mangia3/bird/README.md

# bird

revisiting one of my high school senior thesis projects

[[timf](https://aryan-cs.github.io/bird/timf.pdf)] [[rcgroup](https://www.rcgroups.com/forums/showthread.php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)]
