mangia3/bird/jet/LW-PLA/F22_Raptor_Fuselage/Sawtooth_Nosecone/f22_raptor_nose_main.stl

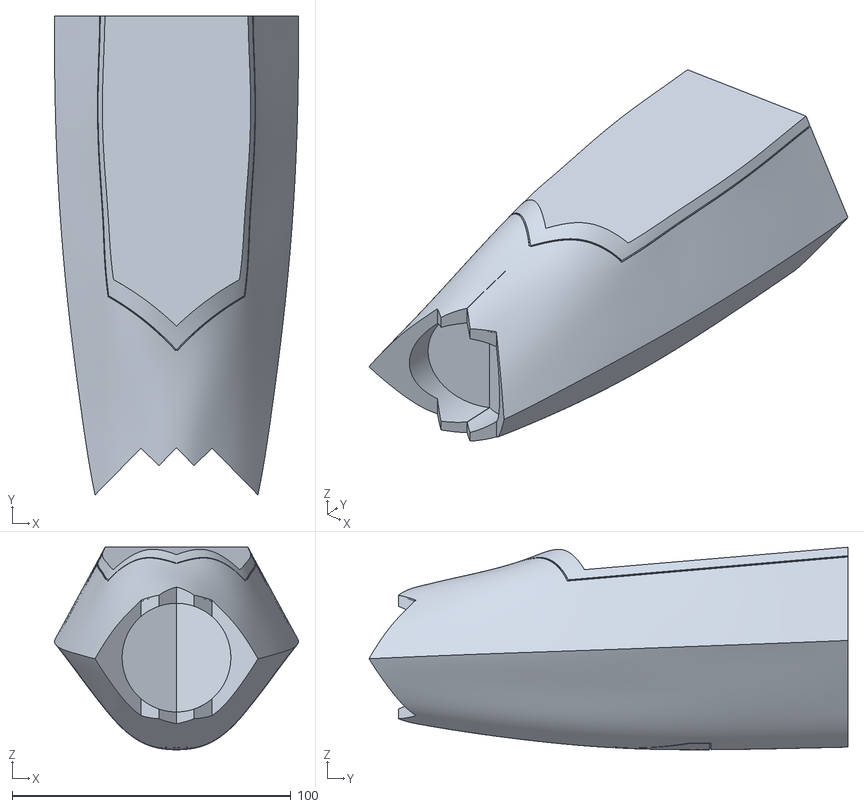
[picture p9: CAD file, 2026-05-17]
jet/LW-PLA/F22_Raptor_Fuselage/Sawtooth_Nosecone/f22_raptor_nose_main.stl
87.7 x 171.9 x 72.7
