mangia3/bird/jet/LW-PLA/F22_Raptor_Fuselage/f22_raptor_fuse_3_twin.stl

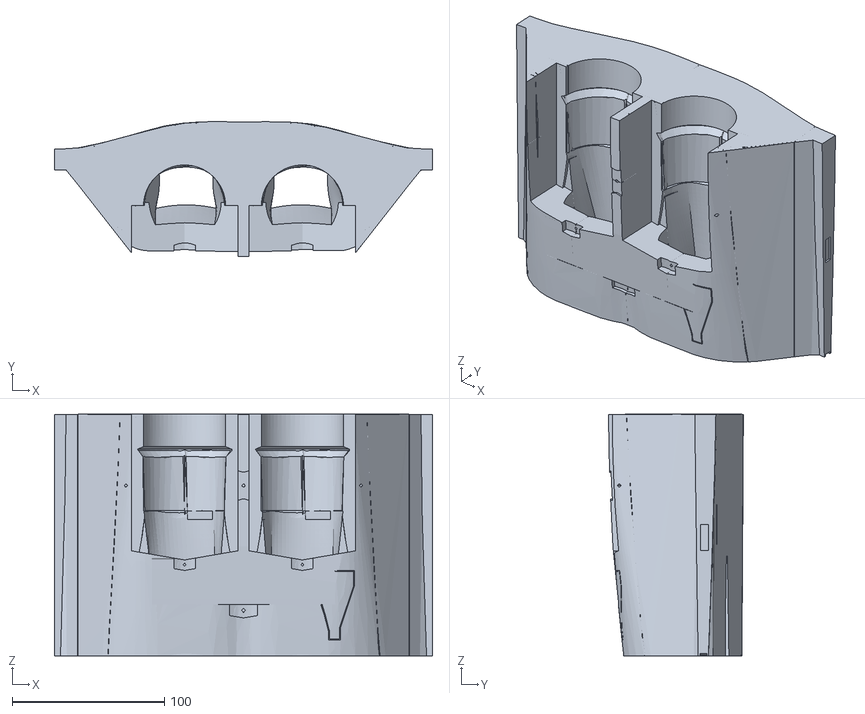
[picture p10: CAD file, 2026-06-01]
jet/LW-PLA/F22_Raptor_Fuselage/f22_raptor_fuse_3_twin.stl
248.3 x 88.5 x 158.6
