mangia3/bird/jet/LW-PLA/F22_Raptor_Fuselage/Simple_Nosecone/f22_raptor_nose_2.stl

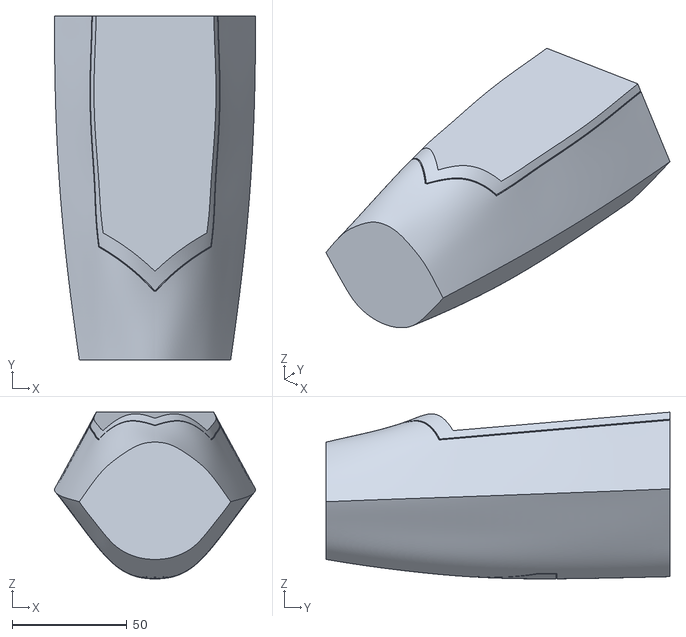
[picture p11: CAD file, 2026-05-17]
jet/LW-PLA/F22_Raptor_Fuselage/Simple_Nosecone/f22_raptor_nose_2.stl
87.7 x 150.0 x 72.7
