mangia3/bird/jet/LW-PLA/F22_Raptor_HStab/f22_raptor_hstab_l.stl

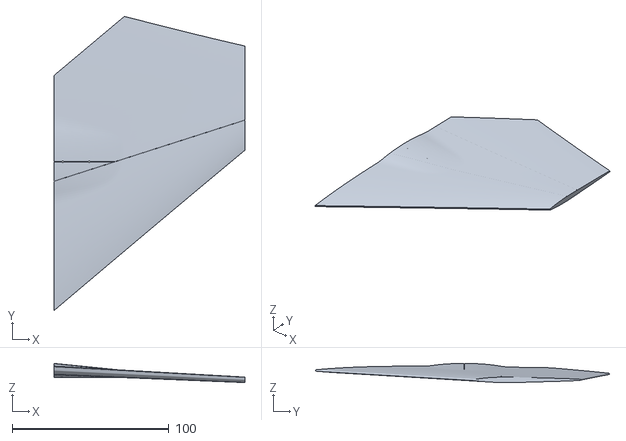
[picture p12: CAD file, 2026-05-17]
jet/LW-PLA/F22_Raptor_HStab/f22_raptor_hstab_l.stl
122.0 x 187.9 x 12.3
