mangia3/bird/jet/LW-PLA/F22_Raptor_VStab/f22_raptor_rear_vstab_r.stl

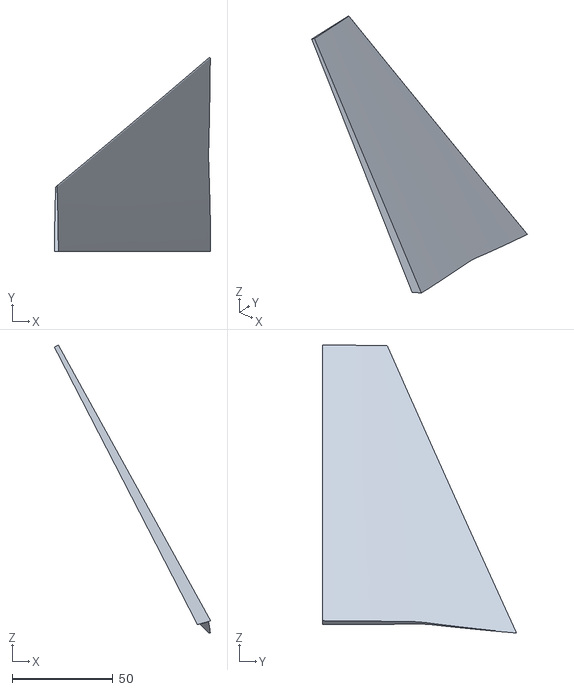
[picture p13: CAD file, 2026-05-17]
jet/LW-PLA/F22_Raptor_VStab/f22_raptor_rear_vstab_r.stl
77.5 x 96.3 x 142.9
