mangia3/bird/jet/LW-PLA/F22_Raptor_Wings/F22_Raptor_Wing_Left/f22_raptor_wing_l_tip.stl

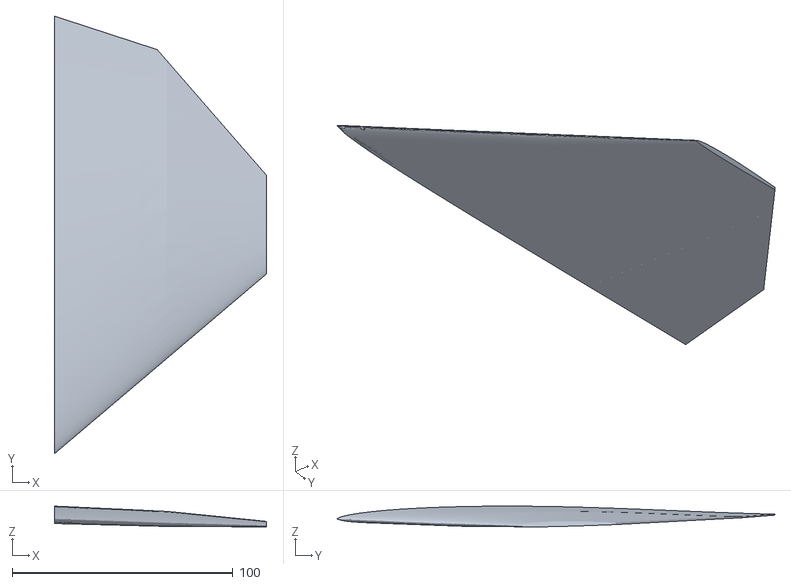
[picture p14: CAD file, 2026-05-17]
jet/LW-PLA/F22_Raptor_Wings/F22_Raptor_Wing_Left/f22_raptor_wing_l_tip.stl
96.0 x 198.2 x 9.42
