mangia3/bird/jet/LW-PLA/F22_Raptor_Wings/F22_Raptor_Wing_Right/f22_wing_r1b_no_servo.stl

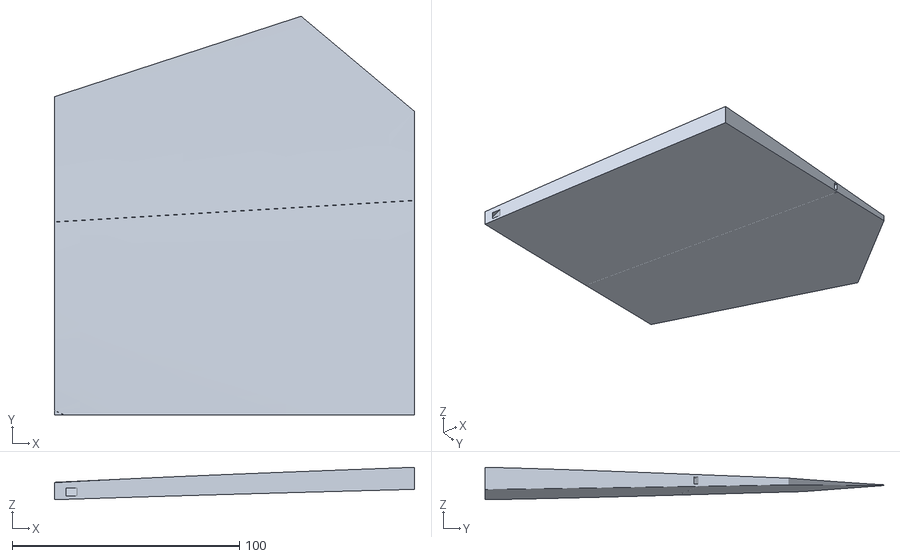
[picture p15: CAD file, 2026-05-17]
jet/LW-PLA/F22_Raptor_Wings/F22_Raptor_Wing_Right/f22_wing_r1b_no_servo.stl
158.5 x 175.5 x 14.3
