mangia3/bird/jet/LW-PLA/F22_Raptor_Fuselage/f22_raptor_fuse_4_twin.stl

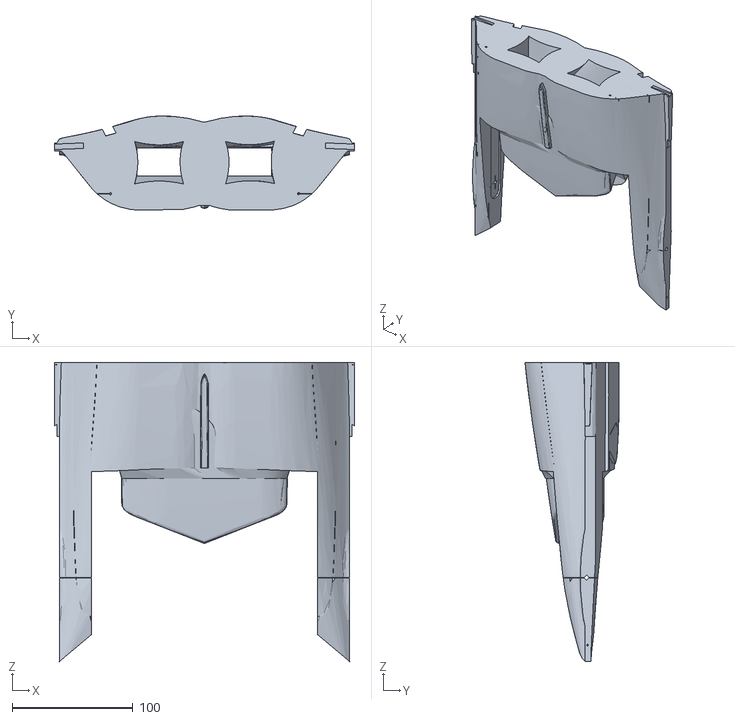
[picture p16: CAD file, 2026-06-01]
jet/LW-PLA/F22_Raptor_Fuselage/f22_raptor_fuse_4_twin.stl
248.3 x 77.9 x 247.5
