mangia3/bird/jet/LW-PLA/F22_Raptor_HStab/f22_raptor_hstab_l_rear.stl

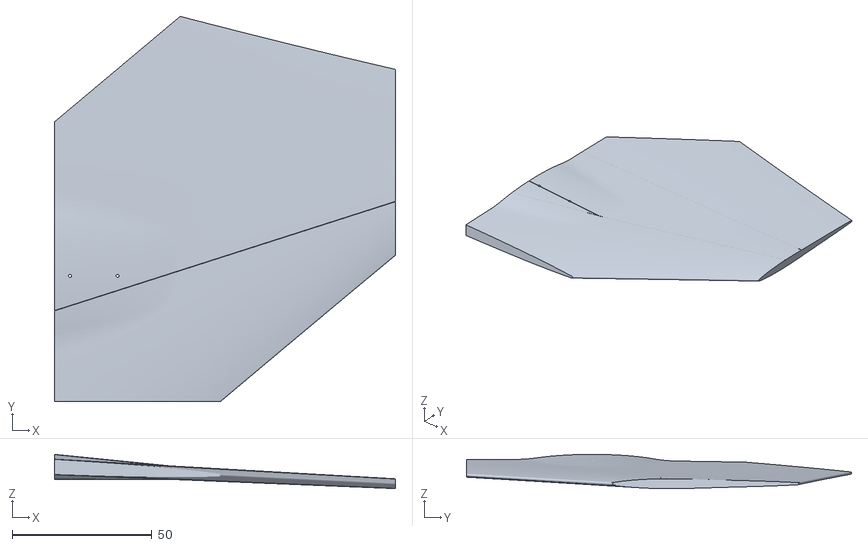
[picture p17: CAD file, 2026-05-17]
jet/LW-PLA/F22_Raptor_HStab/f22_raptor_hstab_l_rear.stl
122.0 x 137.8 x 12.3
