mangia3/bird/jet/LW-PLA/F22_Raptor_VStab/f22_raptor_vstab_l.stl

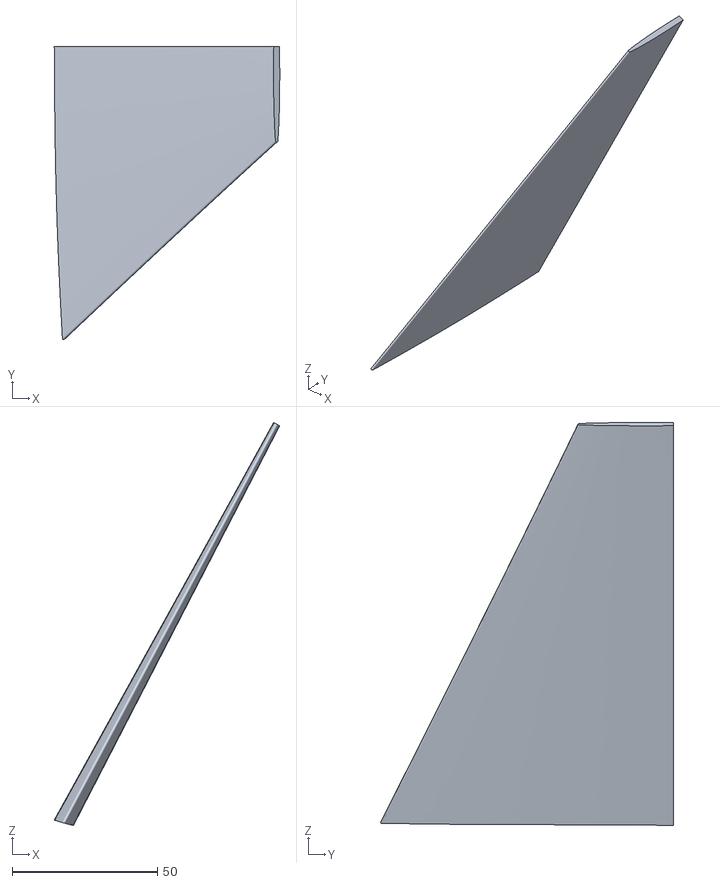
[picture p18: CAD file, 2026-05-17]
jet/LW-PLA/F22_Raptor_VStab/f22_raptor_vstab_l.stl
77.6 x 101.0 x 138.7
