mangia3/bird/jet/LW-PLA/F22_Raptor_Wings/F22_Raptor_Wing_Right/f22_raptor_wing_r1b.stl

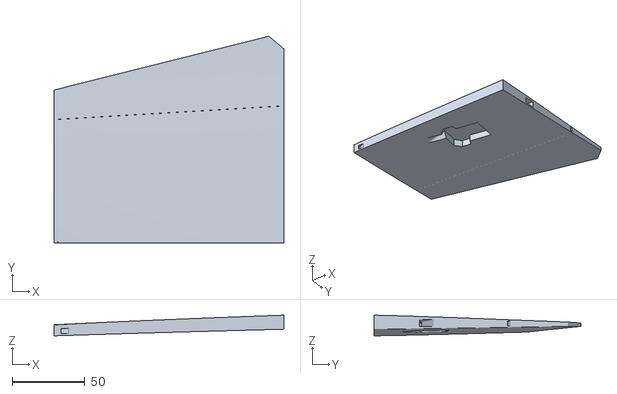
[picture p19: CAD file, 2026-05-17]
jet/LW-PLA/F22_Raptor_Wings/F22_Raptor_Wing_Right/f22_raptor_wing_r1b.stl
158.5 x 142.3 x 14.3
