mangia3/bird/jet/LW-PLA/F22_Raptor_Fuselage/f22_raptor_fuse_2_twin.stl

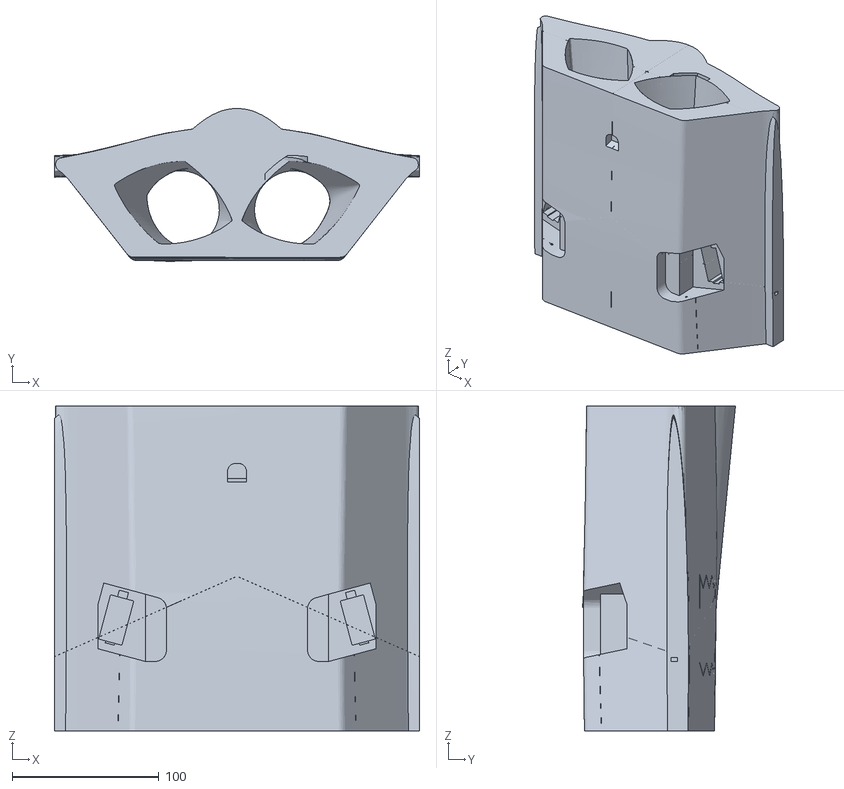
[picture p20: CAD file, 2026-06-01]
jet/LW-PLA/F22_Raptor_Fuselage/f22_raptor_fuse_2_twin.stl
248.3 x 104.1 x 221.0
