mangia3/bird/jet/LW-PLA/F22_Raptor_HStab/f22_raptor_taileron_horn.stl

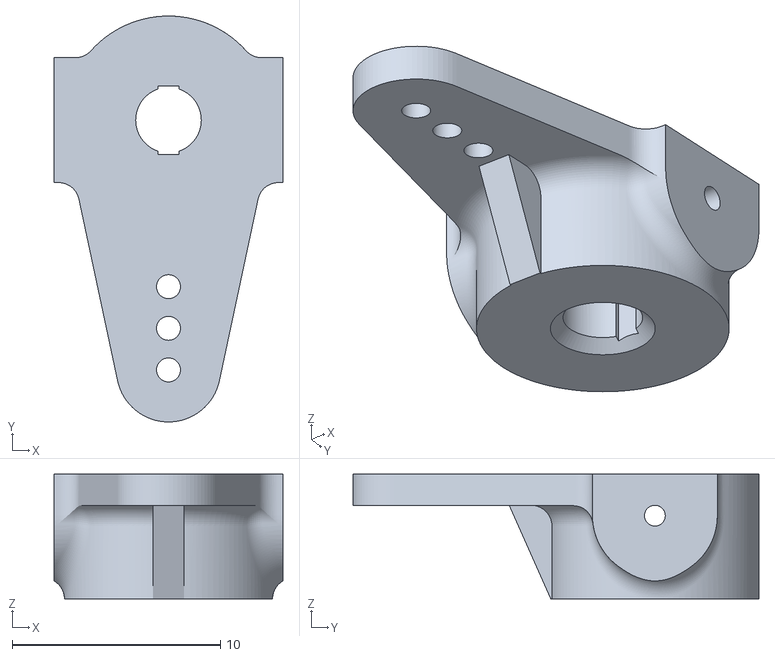
[picture p21: CAD file, 2026-05-17]
jet/LW-PLA/F22_Raptor_HStab/f22_raptor_taileron_horn.stl
11.0 x 19.5 x 6.00
