mangia3/bird/jet/LW-PLA/F22_Raptor_Wings/F22_Raptor_Wing_Right/f22_raptor_r_ail_outer.stl

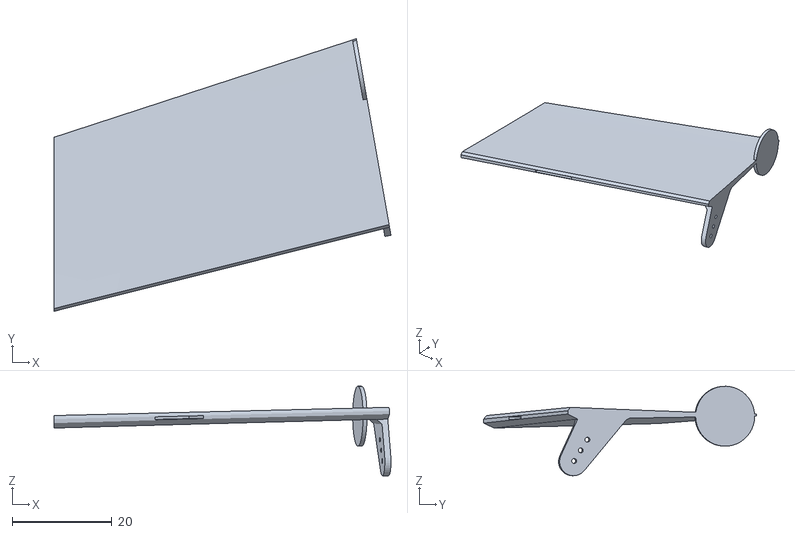
[picture p22: CAD file, 2026-05-17]
jet/LW-PLA/F22_Raptor_Wings/F22_Raptor_Wing_Right/f22_raptor_r_ail_outer.stl
67.4 x 54.5 x 17.9
