mangia3/bird/jet/LW-PLA/F22_Raptor_Fuselage/f22_raptor_fuse_3.stl

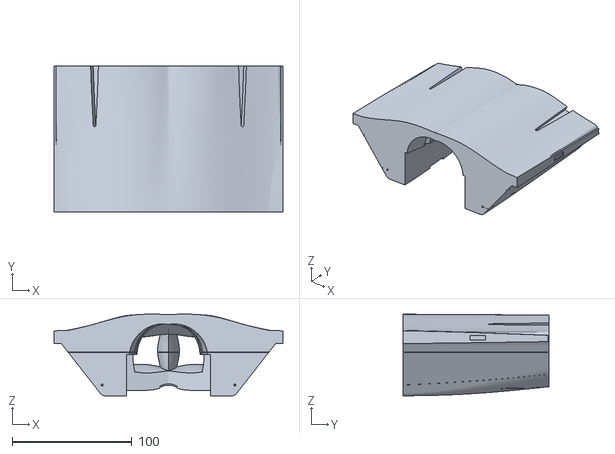
[picture p23: CAD file, 2026-05-17]
jet/LW-PLA/F22_Raptor_Fuselage/f22_raptor_fuse_3.stl
191.0 x 122.0 x 68.2
