mangia3/bird/jet/LW-PLA/F22_Raptor_Wings/F22_Raptor_Wing_Left/f22_raptor_l_ail_inner.stl

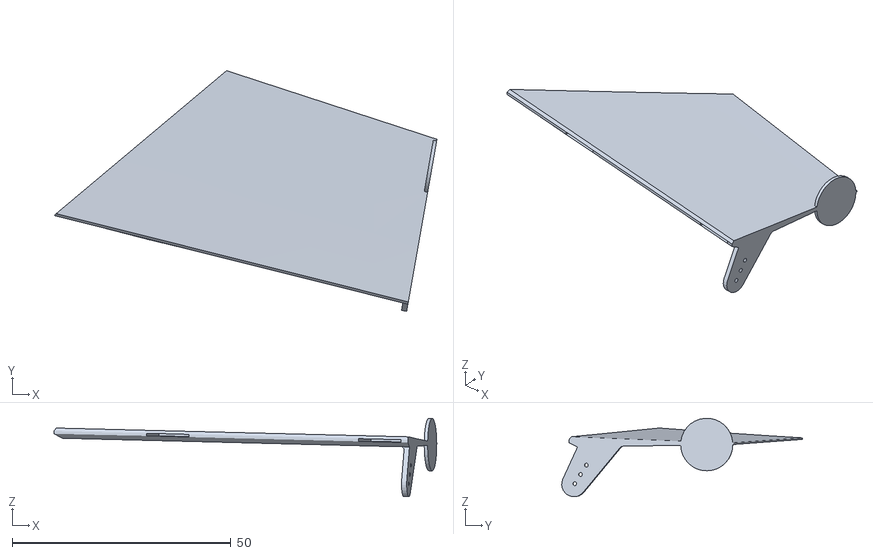
[picture p24: CAD file, 2026-05-17]
jet/LW-PLA/F22_Raptor_Wings/F22_Raptor_Wing_Left/f22_raptor_l_ail_inner.stl
87.6 x 55.0 x 17.9
