mangia3/bird/jet/LW-PLA/F22_Raptor_Fuselage/f22_raptor_fuse_1_lowfloor.stl

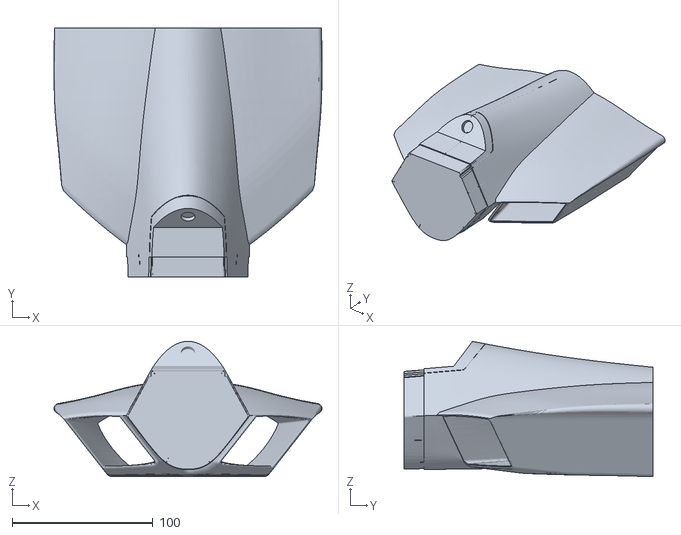
[picture p25: CAD file, 2026-05-17]
jet/LW-PLA/F22_Raptor_Fuselage/f22_raptor_fuse_1_lowfloor.stl
190.6 x 177.0 x 96.3
