mangia3/bird/jet/LW-PLA/F22_Raptor_Fuselage/f22_raptor_fan_hatch.stl

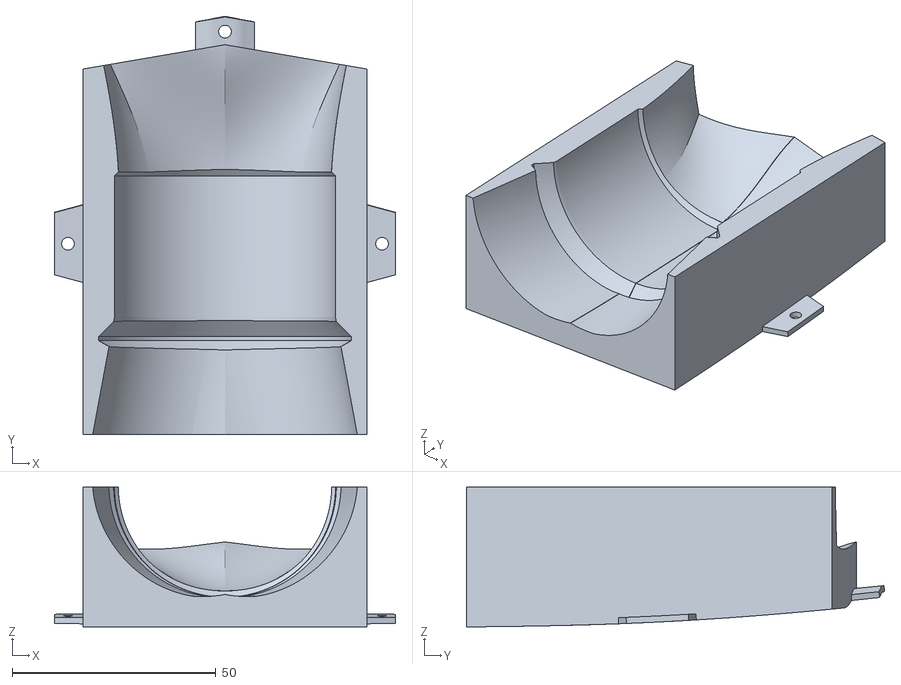
[picture p26: CAD file, 2026-05-17]
jet/LW-PLA/F22_Raptor_Fuselage/f22_raptor_fan_hatch.stl
83.6 x 102.5 x 34.3
