mangia3/bird/jet/LW-PLA/F22_Raptor_HStab/f22_raptor_hstab_l_front.stl

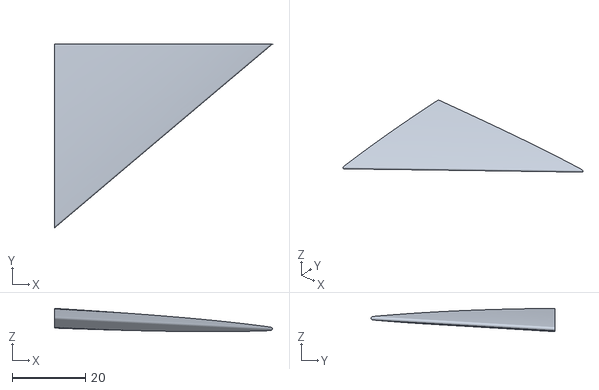
[picture p27: CAD file, 2026-05-17]
jet/LW-PLA/F22_Raptor_HStab/f22_raptor_hstab_l_front.stl
59.4 x 50.1 x 6.35
