mangia3/bird/jet/LW-PLA/F22_Raptor_Fuselage/f22_raptor_fuse_4_laminate_r.stl

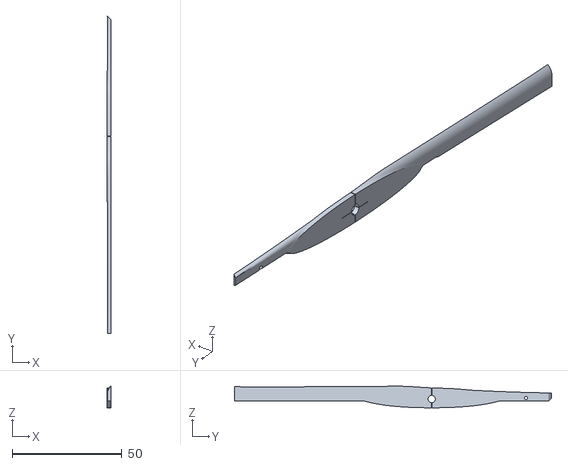
[picture p28: CAD file, 2026-05-17]
jet/LW-PLA/F22_Raptor_Fuselage/f22_raptor_fuse_4_laminate_r.stl
1.60 x 144.7 x 9.87
