mangia3/bird/jet/LW-PLA/F22_Raptor_Fuselage/f22_raptor_canopy.stl

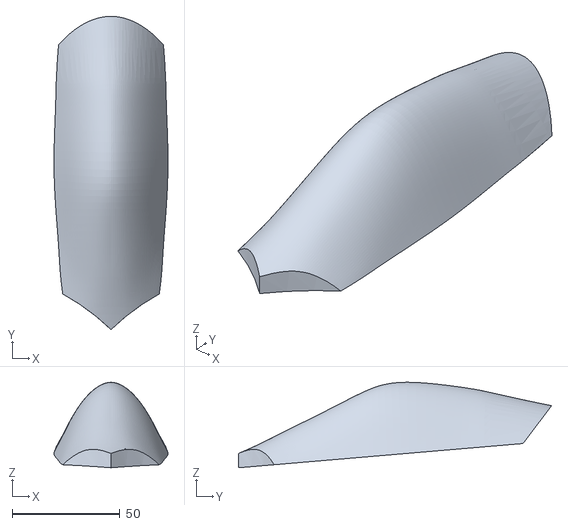
[picture p30: CAD file, 2026-05-17]
jet/LW-PLA/F22_Raptor_Fuselage/f22_raptor_canopy.stl
53.0 x 145.6 x 39.8
