mangia3/bird/jet/LW-PLA/F22_Raptor_Fuselage/f22_raptor_ele_horn_cover_r.stl

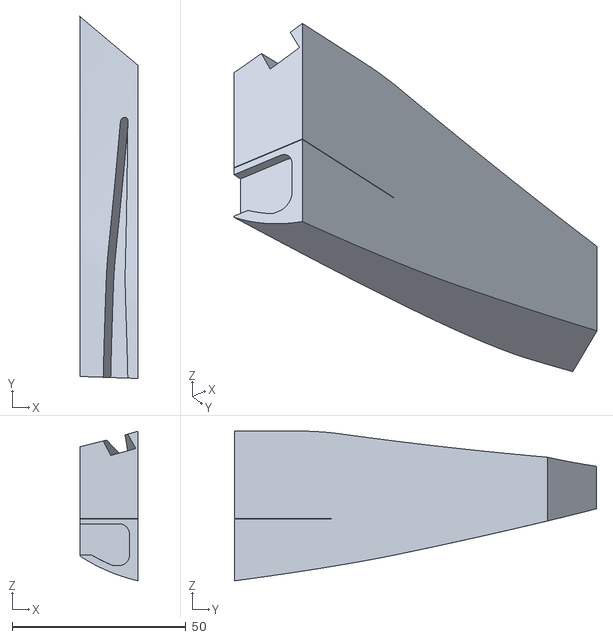
[picture p31: CAD file, 2026-05-17]
jet/LW-PLA/F22_Raptor_Fuselage/f22_raptor_ele_horn_cover_r.stl
16.8 x 104.1 x 43.1
