mangia3/bird/jet/LW-PLA/F22_Raptor_Fuselage/f22_raptor_fuse_4_laminate_l2.stl

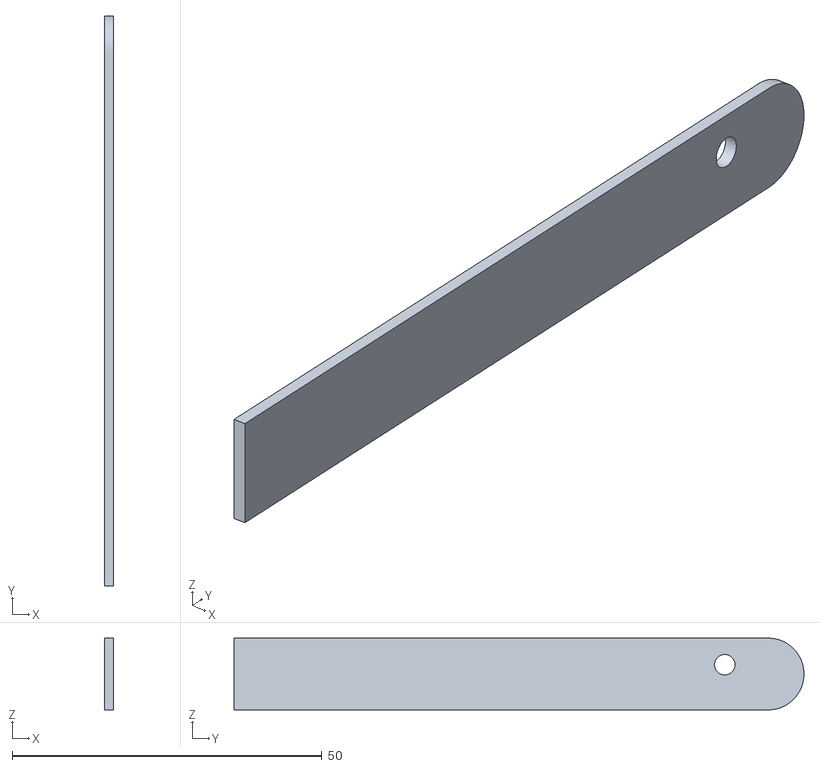
[picture p32: CAD file, 2026-05-17]
jet/LW-PLA/F22_Raptor_Fuselage/f22_raptor_fuse_4_laminate_l2.stl
1.40 x 92.1 x 11.6
