mangia3/bird/(list of files, cad)

Other CAD files:
jet/LW-PLA/F22_Raptor_Wings/F22_Raptor_Wing_Left/f22_wing_l1b_no_servo.stl
jet/LW-PLA/F22_Raptor_VStab/f22_raptor_rear_vstab_l.stl
jet/LW-PLA/F22_Raptor_Wings/F22_Raptor_Wing_Left/f22_raptor_wing_l1b.stl
jet/LW-PLA/F22_Raptor_HStab/f22_raptor_hstab_r.stl
jet/LW-PLA/F22_Raptor_Wings/F22_Raptor_Wing_Right/f22_raptor_r_ail_inner.stl
jet/LW-PLA/F22_Raptor_HStab/f22_raptor_hstab_r_rear.stl
jet/LW-PLA/F22_Raptor_Fuselage/f22_raptor_ele_horn_cover_l.stl
jet/LW-PLA/F22_Raptor_Fuselage/f22_raptor_fuse_4_laminate_r2.stl
