mangia3/bird/(commit log)

2026-05-17 add f22_raptor_fuse_4_laminate_r2.stl
    [f22_raptor_fuse_4_laminate_r2.stl]
2026-05-17 add f22_raptor_fuse_4_laminate_l2.stl
    [f22_raptor_fuse_4_laminate_l2.stl]
2026-05-17 add f22_raptor_l_ail_inner.stl
    [f22_raptor_l_ail_inner.stl]
2026-05-17 add f22_raptor_hstab_r_front.stl
    [f22_raptor_hstab_r_front.stl]
2026-05-17 add f22_raptor_r_ail_inner.stl
    [f22_raptor_r_ail_inner.stl]
2026-05-17 add f22_raptor_r_ail_outer.stl
    [f22_raptor_r_ail_outer.stl]
2026-05-17 add f22_raptor_hstab_l_front.stl
    [f22_raptor_hstab_l_front.stl]
2026-05-17 add f22_raptor_ele_horn_cover_l.stl
    [f22_raptor_ele_horn_cover_l.stl]
2026-05-17 add f22_raptor_ele_horn_cover_r.stl
    [f22_raptor_ele_horn_cover_r.stl]
2026-05-17 add f22_raptor_hstab_r_rear.stl
    [f22_raptor_hstab_r_rear.stl]
2026-05-17 add f22_raptor_hstab_r.stl
    [f22_raptor_hstab_r.stl]
2026-05-17 add f22_raptor_canopy.stl
    [f22_raptor_canopy.stl]
2026-05-17 add f22_raptor_wing_r1b.stl
    [f22_raptor_wing_r1b.stl]
2026-05-17 add f22_raptor_fuse_4_laminate_r.stl
    [f22_raptor_fuse_4_laminate_r.stl]
2026-05-17 add f22_wing_r1b_no_servo.stl
    [f22_wing_r1b_no_servo.stl]
2026-05-17 add f22_raptor_rear_vstab_l.stl
    [f22_raptor_rear_vstab_l.stl]
2026-05-17 add f22_raptor_vstab_l.stl
    [f22_raptor_vstab_l.stl]
2026-05-17 add f22_raptor_taileron_horn.stl
    [f22_raptor_taileron_horn.stl]
2026-05-17 add f22_raptor_fan_hatch.stl
    [f22_raptor_fan_hatch.stl]
2026-05-17 add f22_raptor_hstab_l_rear.stl
    [f22_raptor_hstab_l_rear.stl]
2026-05-17 add f22_raptor_hstab_l.stl
    [f22_raptor_hstab_l.stl]
2026-05-17 add f22_raptor_fuse_1_lowfloor.stl
    [f22_raptor_fuse_1_lowfloor.stl]
2026-05-17 add f22_raptor_rear_vstab_r.stl
    [f22_raptor_rear_vstab_r.stl]
2026-05-17 add f22_raptor_wing_l1b.stl
    [f22_raptor_wing_l1b.stl]
2026-05-17 add f22_wing_l1b_no_servo.stl
    [f22_wing_l1b_no_servo.stl]
2026-05-17 add f22_raptor_wing_l_tip.stl
    [f22_raptor_wing_l_tip.stl]
2026-05-17 add f22_raptor_fuse_3.stl
    [f22_raptor_fuse_3.stl]
2026-05-17 add f22_raptor_nose_2.stl
    [f22_raptor_nose_2.stl]
2026-05-17 add f22_raptor_nose_main.stl
    [f22_raptor_nose_main.stl]
2026-05-17 add f22_raptor_fuse_4.stl
2026-05-17 add f22_raptor_wing_r1f.stl
2026-05-17 add f22_raptor_wing_r_tip.stl
2026-05-17 add f22_raptor_wing_l1f.stl
2026-05-17 add f22_raptor_nose_1.stl
2026-05-17 add f22_raptor_nose.stl
2026-05-26 Index: page title to "bird files" + sync README tagline + links
    - <title> changed from "bird — F-22 Raptor STL viewer" to "bird files".
    - Added the README tagline ("revisiting one of my high school senior thesis
    projects") and the four [timf]/[rcgroup]/[files]/[repo] links under the
    bird heading so the index mirrors README.md.
2026-05-26 Viewer: add Surface angle toggle (MeshNormalMaterial)
    Mirrors github.com's STL viewer Surface Angle button — swaps the material
    to MeshNormalMaterial which colors each face by its normal direction.
    Wireframe and Surface angle compose: you can toggle both on at once.
2026-05-26 Delete obsolete jet/f22.stl
    Replaced by jet/f22.json manifest + multi-part loader in viewer.html.
2026-05-27 Viewer: part interactions + 3 new subassembly manifests
    Multi-part viewer interactions:
    - Hover a part -> blue outline + filename in bottom-right (black outline
    in Surface Angle mode for contrast). Outlines pre-computed in the
    background so first-hover on the 1.4M-tri Fuse 2 is instant.
    - Hover throttled to one rAF tick and skipped during pointer-down, so
    fast orbit drags never lag.
    - Left-click a part -> opens that part's STL in a new tab.
    - Right-click OR Shift+click a part -> toggles its visibility. Shift+
    click works around Mac trackpad right-click ergonomics. Raycast sees
    through hidden parts so the same gesture brings them back.
    - Shift+hover -> peek-hides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
2026-05-30 Viewer: add Download button on single-STL pages
    Shows up in the bottom toolbar after a single-STL view finishes loading.
    Hidden on .json multi-part pages (since there's no single file to grab).
    Click triggers a blob download from the already-fetched buffer, saving
    the file with its original name (e.g. f22_raptor_fuse_3.stl). We use a
    blob URL rather than <a download> on the jsDelivr URL because the
    download attribute is unreliable cross-origin.
2026-06-01 Add CAD files to fix incorrect EDF setup
    [f22_raptor_fuse_2_twin.stl, f22_raptor_fuse_3_twin.stl, f22_raptor_fuse_4_twin.stl]
